Ekko-Technology/Alex_Project/README.md

ALEX Project
AY 2024/25 Sem 2
Done by
Joshua Yeo Wee Tze
Rajeshprabu Sidharth
Karthikeyan Vetrivel
Gao Shao Ann

Sid and Vetri will be TAing this mod the upcoming sem (AY 25/26)
