Ekko-Technology/Alex_Project/SSH_alex/Alex/robotlib.ino

#include <AFMotor.h>

// Motor control
#define FRONT_LEFT   2 // M4 on the driver shield
#define FRONT_RIGHT  1 // M1 on the driver shield
#define BACK_LEFT    3 // M3 on the driver shield
#define BACK_RIGHT   4 // M2 on the driver shield

AF_DCMotor motorFL(FRONT_LEFT);
AF_DCMotor motorFR(FRONT_RIGHT);
AF_DCMotor motorBL(BACK_LEFT);
AF_DCMotor motorBR(BACK_RIGHT);

void move(float speed, int direction)
{
  int speed_scaled = (speed/100.0) * 255;
  motorFL.setSpeed(speed_scaled);
  motorFR.setSpeed(speed_scaled);
  motorBL.setSpeed(speed_scaled*1.1);
  motorBR.setSpeed(speed_scaled);

  switch(direction)
    {
      case BACK:
        motorFL.run(FORWARD);
        motorFR.run(BACKWARD);
        motorBL.run(FORWARD);
        motorBR.run(BACKWARD); 
      break;
      case GO:
        motorFL.run(BACKWARD);
        motorFR.run(FORWARD);
        motorBL.run(BACKWARD);
        motorBR.run(FORWARD); 
      break;
      case CW:
        motorFL.run(BACKWARD);
        motorFR.run(BACKWARD);
        motorBL.run(BACKWARD);
        motorBR.run(BACKWARD); 
      break;
      case CCW:
        motorFL.run(FORWARD);
        motorFR.run(FORWARD);
        motorBL.run(FORWARD);
        motorBR.run(FORWARD); 
      break;
      case STOP:
      default:
        motorFL.run(STOP);
        motorFR.run(STOP);
        motorBL.run(STOP);
        motorBR.run(STOP); 
    }
}

void forward(float dist, float speed)
{
  dir = (TDirection) FORWARD;
  move(speed, FORWARD);
}

void backward(float dist, float speed)  
{
  dir = (TDirection) BACKWARD;
  move(speed, BACKWARD);
}

void ccw(float dist, float speed)
{
  dir = (TDirection) LEFT;
  move(speed, LEFT); // check again (LEFT or CCW)
}

void cw(float dist, float speed)
{
  dir = (TDirection) RIGHT;
  move(speed, RIGHT); // check again (RIGHT or CW)
}

void stop()
{
  dir = (TDirection) STOP;
  move(0, STOP);
}

void fforward(float dist, float speed) {
  if(dist > 0)
    deltaDist = dist;
  else
    deltaDist=9999999;
  newDist = forwardDist + deltaDist;
  forward(dist, speed);
}

void reverse(float dist, float speed) {
  if(dist > 0)
    deltaDist = dist;
  else
    deltaDist=9999999;
  newDist = reverseDist + deltaDist;
  backward(dist, speed);
}

void left(float ang, float speed) {
  if(ang == 0)
    deltaTicks=99999999;
  else
    deltaTicks=computeDeltaTicks(ang);
  targetTicks = leftReverseTicksTurns + deltaTicks;
  ccw(ang, speed);
}

void right(float ang, float speed) {
  if(ang == 0)
    deltaTicks=99999999;
  else
    deltaTicks=computeDeltaTicks(ang);
  targetTicks = leftForwardTicksTurns + deltaTicks;
  cw(ang, speed);
}
