Ekko-Technology/Alex_Project/SSH_alex/Alex/variables.h

volatile TDirection dir;

// Store the ticks from Alex's left and
// right encoders.
volatile unsigned long leftForwardTicks; 
volatile unsigned long rightForwardTicks;
volatile unsigned long leftReverseTicks; 
volatile unsigned long rightReverseTicks;

// Left and right encoder ticks for turning
volatile unsigned long leftForwardTicksTurns; 
volatile unsigned long rightForwardTicksTurns;
volatile unsigned long leftReverseTicksTurns; 
volatile unsigned long rightReverseTicksTurns;

// Store the revolutions on Alex's left
// and right wheels
volatile unsigned long leftRevs;
volatile unsigned long rightRevs;

// Forward and backward distance traveled
volatile unsigned long forwardDist;
volatile unsigned long reverseDist;

unsigned long deltaDist;
unsigned long newDist;
unsigned long deltaTicks;
unsigned long targetTicks;
unsigned long targetRightTicks;
unsigned long targetLeftTicks;

float alexDiagonal = 0.0;
float alexCirc = 0.0;
